ShadowDdev/OpenESC_20X20/hardware/BOM/export_project_20260803_234127.xls

4in1-mini.csv |  |  |  |  |  |  |  |  |  | LCSC BOM Quotation
 |  |  |  |  |  |  |  |  |  | BOM Date Created：03/08/26 23:38:18 |  |  |  | BOM Export Date: 03/08/26 23:41:27 |  |  |  | The matching result is a real-time query result, availability and prices may fluctuate. Backorder items are estimated prices for your reference, please submit "Create Quote" to get the real price. All information is provided "as is" and is subject to change without notice. Any use made of the information provided is without recourse to LCSC and at the user's risk.
 |  |  |  |  |  |  |  |  |  | EST TOTAL :$41.48 |  |  |  | Website：https://www.lcsc.com/bom | https://www.lcsc.com/bom | https://www.lcsc.com/bom | https://www.lcsc.com/bom
Uploaded data |  |  |  |  |  |  |  |  |  | LCSC Matching Results
LCSC# | Mfr. | Mrf# | Description | Package | Value | Customer Part Number | Quantity | Target Price(USD) | Target Lead Time(Business Days) | Mrf# | Mfr. | Order Qty. | Unit Price(USD) | Ext.Price(USD) | LCSC# | Package | Min | Mult | SPQ | Availability | Stock Status | Customer Notes | Description | Matched status | Product Link
C105226 |  |  | 22uF |  |  | - | 5 |  |  | CL05A226MQ5QUNC | Samsung Electro-Mechanics | 5 | 0.1031 | 0.52 | C105226 | - | 5 | 5 | 10000 | 0 | Backordered |  | 22uF ±20% 6.3V Ceramic Capacitor X5R 0402 | Exact Matches | https://uat.lcsc.com/product-detail/schottky-barrier-diodes-sbd_lge-10mq040n_C688893.html
C307331 |  |  | 100nF |  |  | - | 100 |  |  | CL05B104KB54PNC | Samsung Electro-Mechanics | 100 | 0.0053 | 0.53 | C307331 | - | 100 | 100 | 10000 | 8000 | In Stock |  | 100nF ±10% 50V Ceramic Capacitor X7R 0402 | Exact Matches
C2762594 |  |  | 22uF |  |  | - | 5 |  |  | CL10A226MO7JZNC | Samsung Electro-Mechanics | 5 | 0.1237 | 0.62 | C2762594 | - | 5 | 5 | 4000 | 219010 | In Stock |  | 22uF ±20% 16V Ceramic Capacitor X5R 0603 | Exact Matches
C181043 |  |  | 100nF |  |  | - | 100 |  |  | GRM033R6YA104KE14D | muRata | 100 | 0.0076 | 0.76 | C181043 | - | 100 | 100 | 15000 | 399200 | In Stock |  | 100nF ±10% 35V Ceramic Capacitor X5R 0201 | Exact Matches
C89632 |  |  | 10uF |  |  | - | 5 |  |  | CL31B106KBHNNNE | Samsung Electro-Mechanics | 5 | 0.2925 | 1.46 | C89632 | - | 5 | 5 | 2000 | 304110 | In Stock |  | 10uF ±10% 50V Ceramic Capacitor X7R 1206 | Exact Matches
C1977154 |  |  | SMF24A-T13 |  |  | - | 5 |  |  | SMF24A-T13 | Littelfuse | 5 | 0.1480 | 0.74 | C1977154 | - | 5 | 5 | 10000 | 8595 | In Stock |  | 38.9VC Clamp 5.1A Ipp TVS DIODE SOD-123FL | Exact Matches
C160407 |  |  | SM08B-SRSS-TB |  |  | - | 5 |  |  | SM08B-SRSS-TB(LF)(SN) | JST | 5 | 0.2524 | 1.26 | C160407 | - | 5 | 5 | 3000 | 322860 | In Stock |  | Connector Header 8 position 1mm Pitch 1A Surface Mount, Right Angle -25℃~+85℃ | Exact Matches
C49441966 |  |  | DOY180N03T |  |  | - | 100 |  |  | DOY180N03T | DOINGTER | 100 | 0.2715 | 27.15 | C49441966 | - | 1 | 1 | 5000 | 823 | In Stock |  | 30V 180A 1.3V 379W 1mΩ@10V 1 N-channel N-Channel TDFN3333-8PL Single FETs, MOSFETs RoHS | Exact Matches
C473542 |  |  | 15R |  |  | - | 100 |  |  | 0201WMF150JTEE | UNI-ROYAL | 100 | 0.0005 | 0.05 | C473542 | - | 100 | 100 | 15000 | 14700 | In Stock |  | 15Ω ±1% 50mW 0201 Thick Film Resistor | Exact Matches
C106225 |  |  | 10k |  |  | - | 100 |  |  | RC0201FR-0710KL | YAGEO | 100 | 0.0012 | 0.12 | C106225 | - | 100 | 100 | 10000 | 1659300 | In Stock |  | 50mW 10kΩ 25V Thick Film Resistor ±1% ±200ppm/℃ 0201 Chip Resistor - Surface Mount RoHS | Exact Matches
C226468 |  |  | 220R |  |  | - | 100 |  |  | AC0201FR-07220RL | YAGEO | 100 | 0.0010 | 0.10 | C226468 | - | 100 | 100 | 10000 | 44400 | In Stock |  | 220Ω ±1% 50mW 0201 Thick Film Resistor | Exact Matches
C270365 |  |  | 1k |  |  | - | 100 |  |  | 0201WMF1001TEE | UNI-ROYAL | 100 | 0.0004 | 0.04 | C270365 | - | 100 | 100 | 15000 | 1163200 | In Stock |  | 1kΩ ±1% 50mW 0201 Thick Film Resistor | Exact Matches
C270365 |  |  | 1k |  |  | - | 100 |  |  | 0201WMF1001TEE | UNI-ROYAL | 100 | 0.0004 | 0.04 | C270365 | - | 100 | 100 | 15000 | 1163200 | In Stock |  | 1kΩ ±1% 50mW 0201 Thick Film Resistor | Exact Matches
C106226 |  |  | 10R |  |  | - | 100 |  |  | RC0201FR-0710RL | YAGEO | 100 | 0.0019 | 0.19 | C106226 | - | 100 | 100 | 10000 | 174400 | In Stock |  | 50mW 10Ω 25V Thick Film Resistor ±1% -100ppm/℃~+350ppm/℃ 0201 Chip Resistor - Surface Mount RoHS | Exact Matches
C106225 |  |  | 10k |  |  | - | 100 |  |  | RC0201FR-0710KL | YAGEO | 100 | 0.0012 | 0.12 | C106225 | - | 100 | 100 | 10000 | 1659300 | In Stock |  | 50mW 10kΩ 25V Thick Film Resistor ±1% ±200ppm/℃ 0201 Chip Resistor - Surface Mount RoHS | Exact Matches
C166378 |  |  | 115k |  |  | - | 100 |  |  | RTT011153FTH | RALEC | 100 | 0.0007 | 0.07 | C166378 | - | 100 | 100 | 10000 | 16600 | In Stock |  | 115kΩ ±1% 50mW 0201 Thick Film Resistor | Exact Matches
C695806 |  |  | 0.2mR |  |  | - | 5 |  |  | ASR-S-3-0.2F | Yezhan | 5 | 0.2345 | 1.17 | C695806 | 2512 | 5 | 5 | 1000 | 2570 | In Stock |  | 6W 0.2mΩ Shunt ±175ppm/℃ ±1% 2512 Chip Resistor - Surface Mount RoHS | Exact Matches | https://www.lcsc.com/product-detail/C695806.html
C2848334 |  |  | TLV76733DRVR |  |  | - | 5 |  |  | TLV76733DRVR | TI | 5 | 0.1660 | 0.83 | C2848334 | - | 5 | 5 | 3000 | 12035 | In Stock |  | Linear Voltage Regulator IC Positive Fixed 1 Output 1A WSON-6(2x2) | Exact Matches
C2765098 |  |  | AT32F421G8U7 |  |  | - | 4 |  |  | AT32F421G8U7 | ARTERY | 4 | 0.6398 | 2.56 | C2765098 | - | 1 | 1 | 490 | 5496 | In Stock |  | ARM Cortex-M4 32 Bit 120MHz 23 QFN-28-EP(4x4) Microcontrollers RoHS | Exact Matches
C41414478 |  |  | NSG2065Q |  |  | - | 4 |  |  | NSG2065Q | WXNSIC | 4 | 0.3911 | 1.56 | C41414478 | - | 1 | 1 | 5000 | 3696 | In Stock |  | 5V~20V 1.5A 1.2A QFN-24-EP(4x4) Gate Drivers RoHS | Exact Matches
C46594347 |  |  | FTC160808S4R7MBCA |  |  | - | 5 |  |  | FTC160808S4R7MBCA | cjiang | 5 | 0.1217 | 0.61 | C46594347 | - | 5 | 5 | 3000 | 37850 | In Stock |  | 1A 4.7uH ±20% 585mΩ 1.2A Molded Inductor 0603 Fixed Inductors RoHS | Exact Matches
C2058245 |  |  | INA186A3IDCKR |  |  | - | 1 |  |  | INA186A3IDCKR | TI | 1 | 0.6721 | 0.67 | C2058245 | - | 1 | 1 | 3000 | 220 | In Stock |  | 1 3uV -200mV~40V 0.3V/us 150dB 500pA 48uA 100V/V SC-70-6 Instrumentation, Op Amps, Buffer Amps RoHS | Exact Matches
C5219316 |  |  | LMR54406DBVR |  |  | - | 1 |  |  | LMR54406DBVR | TI | 1 | 0.3087 | 0.31 | C5219316 | - | 1 | 1 | 3000 | 99933 | In Stock |  | Buck Switching Regulator IC Adjustable 1V~28V 1 Output 0.6A SOT-23-6 | Exact Matches
