ShadowDdev/OpenESC_20X20/hardware/4in1-mini.kicad_pcb

## KiCad design hardware/4in1-mini.kicad_pcb (2026-08-04)

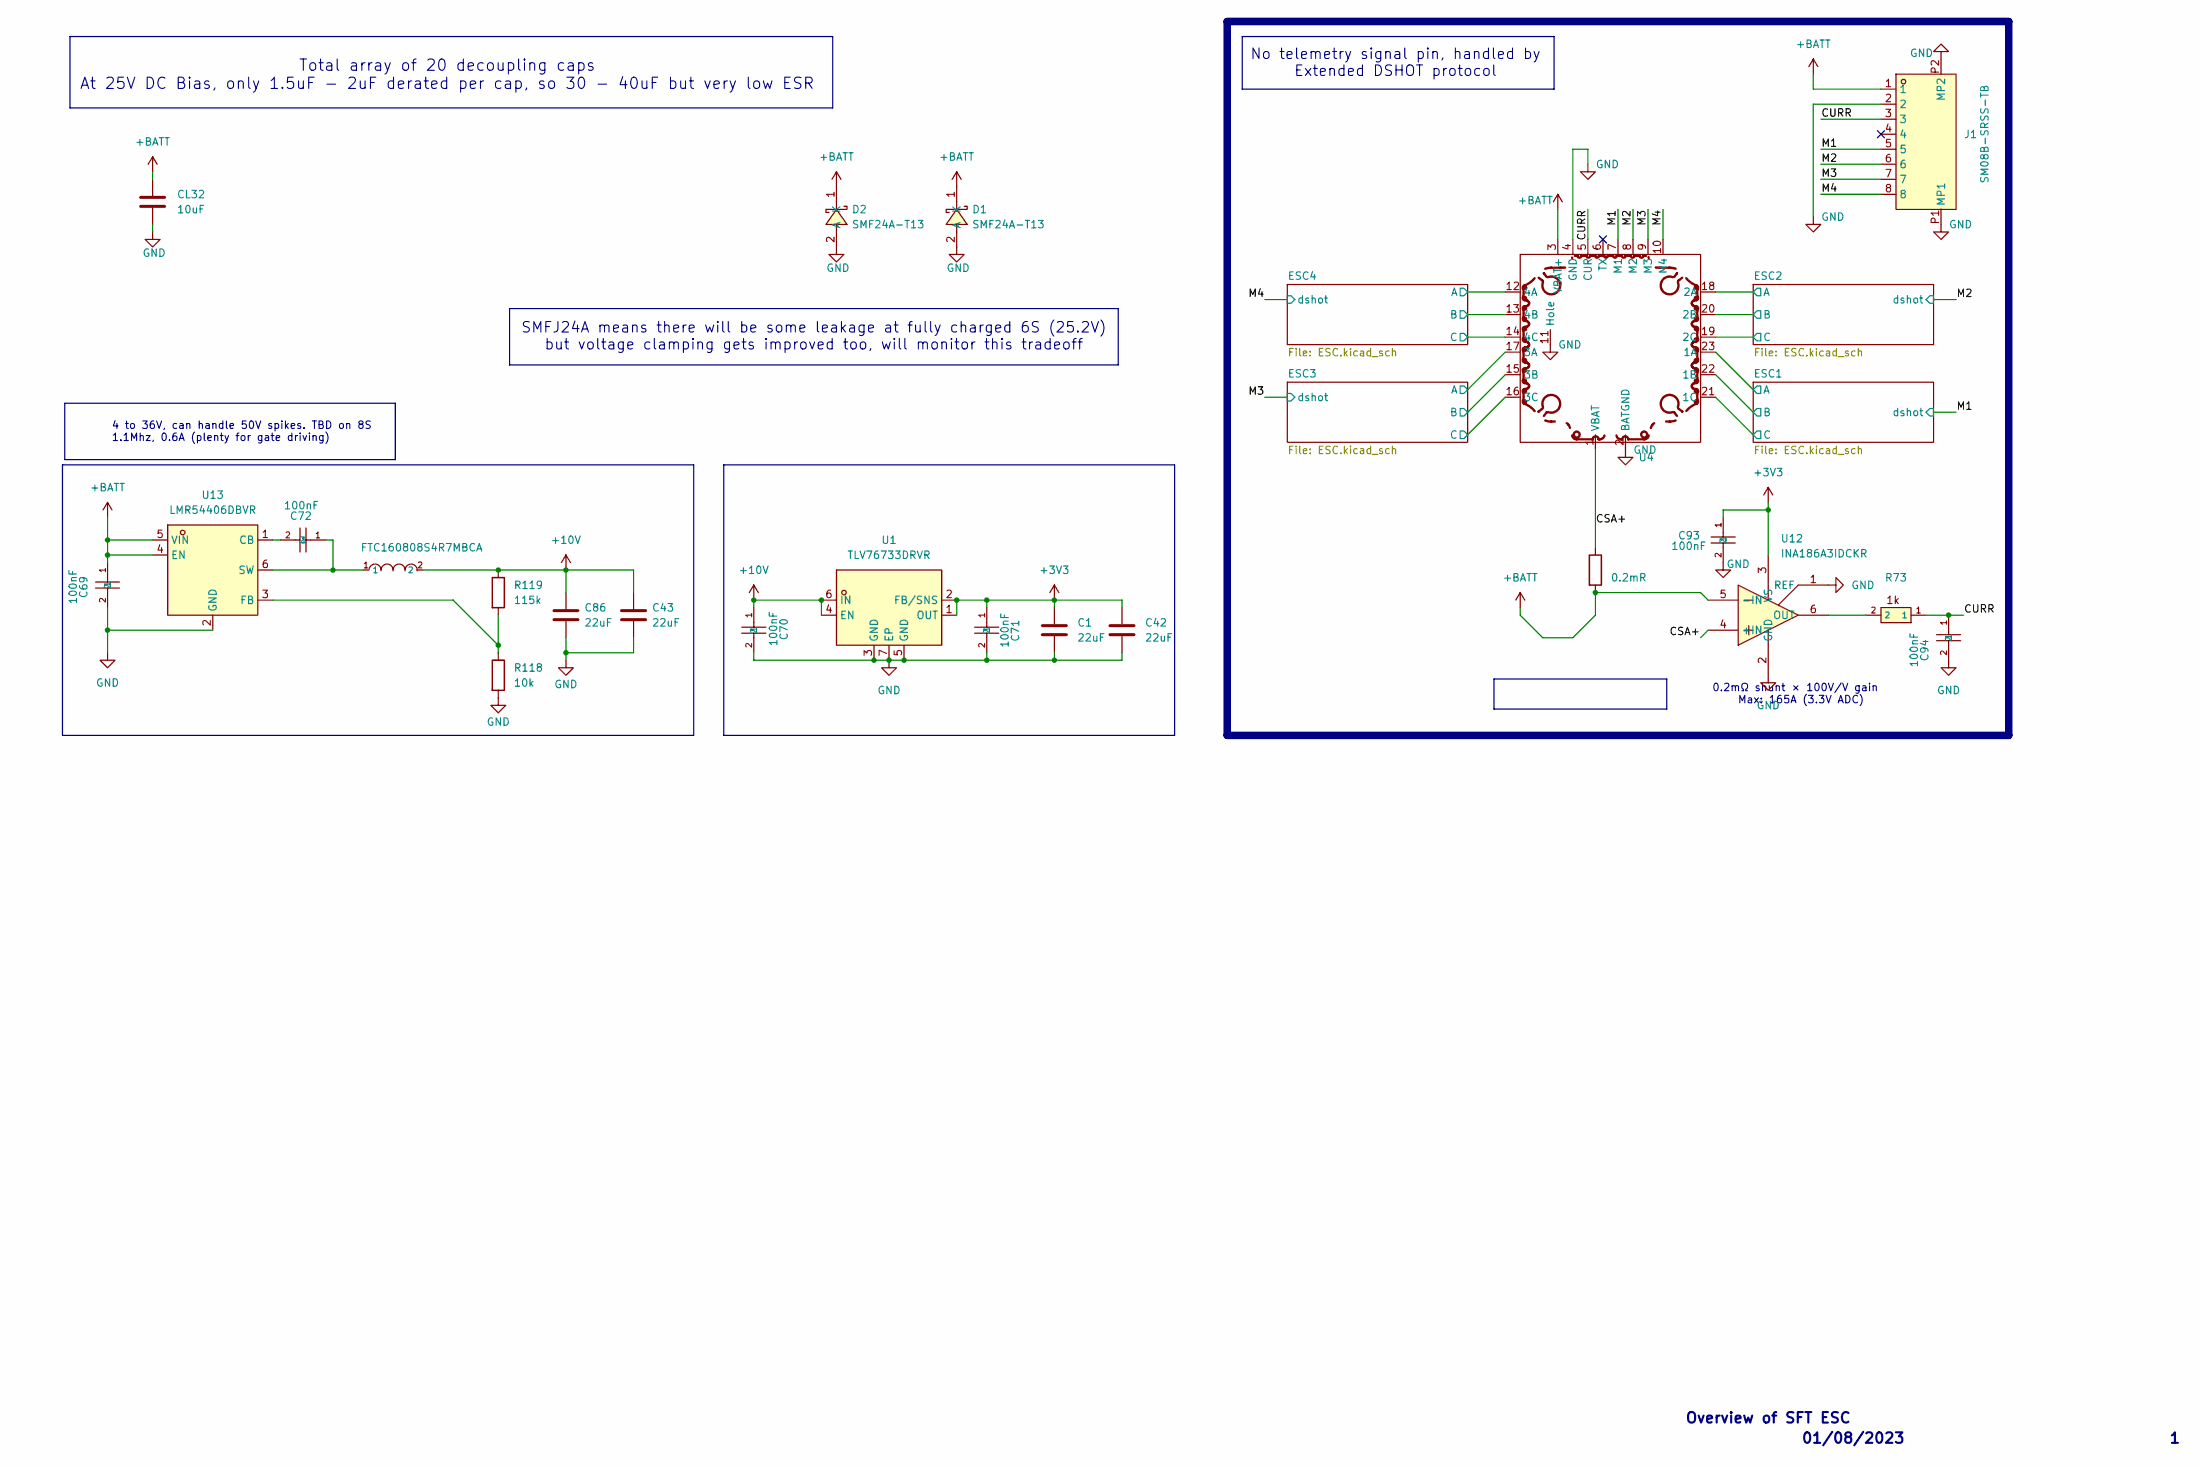
[picture p1: schematic 4in1-mini.kicad_sch]

Parts:
C1, C42: 22uF; C_0402_1005Metric; MPN CL05A226MQ5QUNC; LCSC C105226
C43, C86: 22uF; C_0603_1608Metric; MPN CL10A226MO7JZNC; LCSC C2762594
C69, C70, C71, C72, C93, C94: 100nF; C_0201_0603Metric; MPN GRM033R6YA104KE14D; LCSC C181043
CL32: 10uF; C_1206_3216Metric; MPN CL31B106KBHNNNE; LCSC C89632
D1, D2: SMF24A-T13; SOD-123FL_L2.7-W1.8-LS3.7-RD; MPN SMF24A-T13; LCSC Part C1977154
J1: SM08B-SRSS-TB; JST_SM08B-SRSS-TB; MPN SM08B-SRSS-TB(LF)(SN); LCSC C160407
R73: 1k; R_0201_0603Metric; MPN 0201WMF1001TEE; LCSC C270365
R118: 10k; R_0201_0603Metric; MPN RC0201FR-0710KL; LCSC C106225
R119: 115k; R_0201_0603Metric; MPN RTT011153FTH; LCSC C166378
Rsense1: 0.2mR; R_2512_6332Metric; MPN ASR-S-3-0.2F; LCSC C695806
U1: TLV76733DRVR; WSON-6_L2.0-W2.0-P0.65-TL-EP; MPN TLV76733DRVR; LCSC C2848334
U4: 4in1ESC
U5: FTC160808S4R7MBCA; IND-SMD_L1.6-W0.8_FTC160865SR47MBCA; MPN FTC160808S4R7MBCA; LCSC C46594347
U12: INA186A3IDCKR; SOT-363_SC-70-6; MPN INA186A3IDCKR; LCSC C2058245
U13: LMR54406DBVR; SOT-23-6_L2.9-W1.6-P0.95-LS2.8-BR; MPN LMR54406DBVR; LCSC Part C5219316

Connections:
+3V3: C1.2, C42.2, C71.1, C93.1, U1.1 (OUT), U1.2 (FB/SNS), U12.3 (VS); also elsewhere on the board
+10V: C43.1, C70.1, C86.1, R119.1, U1.4 (EN), U1.6 (IN), U5.2; also elsewhere on the board
+BATT: C69.1, CL32.1, D1.1 (K), D2.1 (K), J1.1, Rsense1.2, U4.3 (VBAT+), U12.5 (-IN), U13.4 (EN), U13.5 (VIN); also elsewhere on the board
/CSA+: Rsense1.1, U4.1 (VBAT), U12.4 (+IN)
/CURR: C94.1, J1.3, R73.1, U4.5 (CUR)
/ESC1/MotorA: U4.23 (1A); also elsewhere on the board
/ESC1/MotorB: U4.22 (1B); also elsewhere on the board
/ESC1/MotorC: U4.21 (1C); also elsewhere on the board
/ESC2/MotorA: U4.18 (2A); also elsewhere on the board
/ESC2/MotorB: U4.20 (2B); also elsewhere on the board
/ESC2/MotorC: U4.19 (2C); also elsewhere on the board
/ESC3/MotorA: U4.17 (3A); also elsewhere on the board
/ESC3/MotorB: U4.15 (3B); also elsewhere on the board
/ESC3/MotorC: U4.16 (3C); also elsewhere on the board
/ESC4/MotorA: U4.12 (4A); also elsewhere on the board
/ESC4/MotorB: U4.13 (4B); also elsewhere on the board
/ESC4/MotorC: U4.14 (4C); also elsewhere on the board
/M1: J1.5, U4.7 (M1); also elsewhere on the board
/M2: J1.6, U4.8 (M2); also elsewhere on the board
/M3: J1.7, U4.9 (M3); also elsewhere on the board
/M4: J1.8, U4.10 (M4); also elsewhere on the board
GND: C1.1, C42.1, C43.2, C69.2, C70.2, C71.2, C86.2, C93.2, C94.2, CL32.2, D1.2 (A), D2.2 (A), J1.2, J1.P1 (MP1), J1.P2 (MP2), R118.2, U1.3 (GND), U1.5 (GND), U1.7 (EP), U4.2 (BATGND), U4.4 (GND), U4.11 (Hole), U12.1 (REF), U12.2 (GND), U13.2 (GND); also elsewhere on the board
unnamed: R73.2, U12.6 (OUT)
unnamed: C72.2, U13.1 (CB)
unnamed: R118.1, R119.2, U13.3 (FB)
unnamed: C72.1, U5.1, U13.6 (SW)

Notes on the sheet:
01/08/2023
No telemetry signal pin, handled by Extended DSHOT protocol
4 to 36V, can handle 50V spikes. TBD on 8S 1.1Mhz, 0.6A (plenty for gate driving)
SMFJ24A means there will be some leakage at fully charged 6S (25.2V) but voltage clamping gets improved too, will monitor this tradeoff
Overview of SFT ESC
Total array of 20 decoupling caps At 25V DC Bias, only 1.5uF - 2uF derated per cap, so 30 - 40uF but very low ESR
0.2mΩ shunt × 100V/V gain Max: 165A (3.3V ADC)

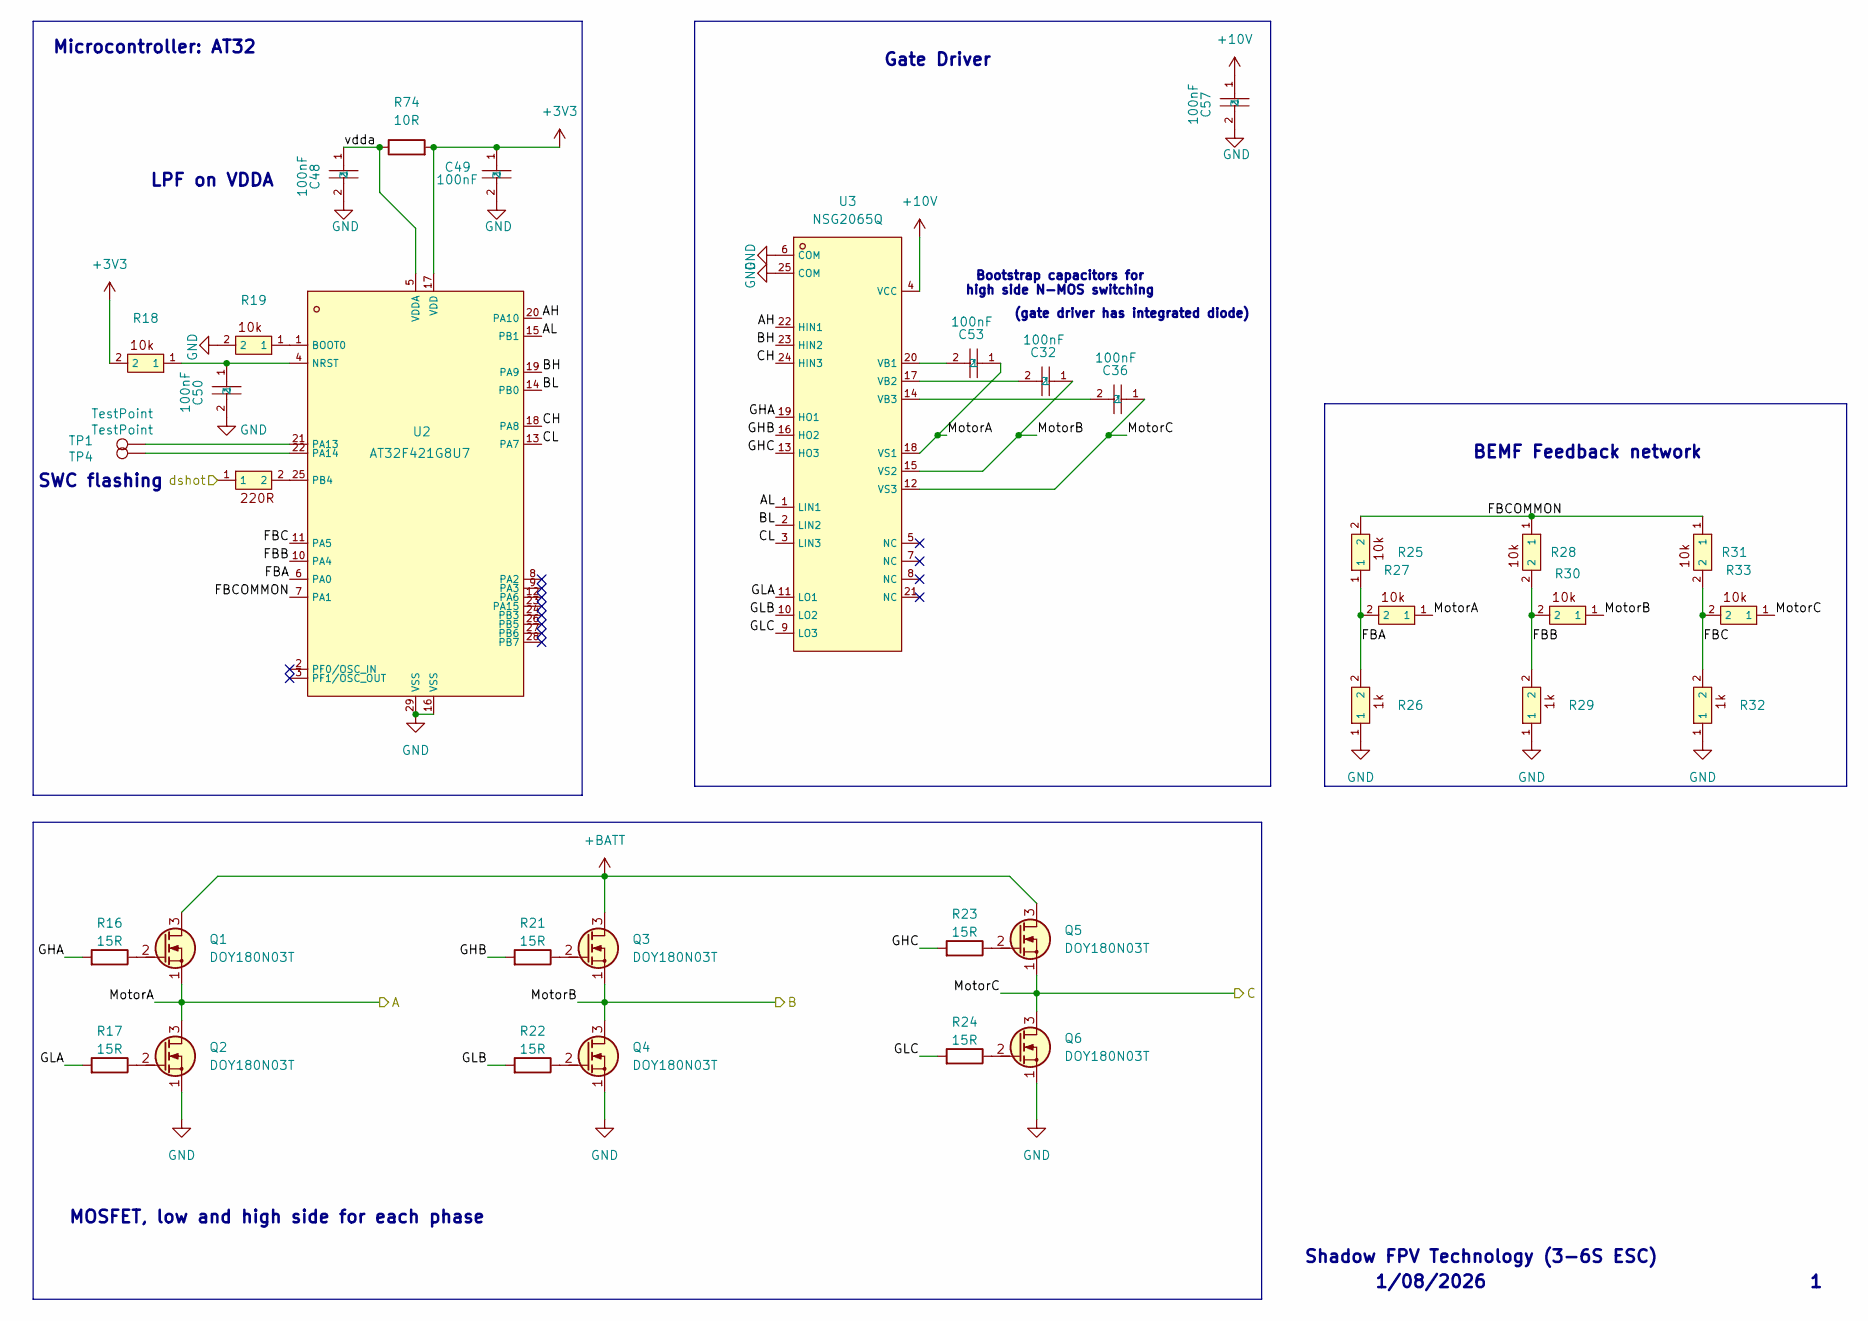
[picture p2: schematic ESC.kicad_sch]

Parts:
C32, C36, C53: 100nF; C_0402_WIDE; MPN CL05B104KB54PNC; LCSC C307331
C48, C49, C50, C57: 100nF; C_0201_0603Metric; MPN GRM033R6YA104KE14D; LCSC C181043
Q1, Q2, Q3, Q4, Q5, Q6: DOY180N03T; Diodes_PowerDI3333-8; MPN DOY180N03T; LCSC C49441966
R16, R17, R21, R22, R23, R24: 15R; R_0201_0603Metric; MPN 0201WMF150JTEE; LCSC C473542
R18, R19, R25, R27, R28, R30, R31, R33: 10k; R_0201_0603Metric; MPN RC0201FR-0710KL; LCSC C106225
R20: 220R; R_0201_0603Metric; MPN AC0201FR-07220RL; LCSC C226468
R26, R29, R32: 1k; R_0201_0603Metric; MPN 0201WMF1001TEE; LCSC C270365
R74: 10R; R_0201_0603Metric; MPN RC0201FR-0710RL; LCSC C106226
TP1, TP4: TestPoint; TestPoint_Pad_D1.0mm
U2: AT32F421G8U7; QFN-28_L4.0-W4.0-P0.40-TL-EP2.4; MPN AT32F421G8U7; LCSC C2765098
U3: NSG2065Q; QFN-24_L4.0-W4.0-P0.50-TL-EP2.8; MPN NSG2065Q; LCSC C41414478

Connections:
+3V3: C49.1, R18.2, R74.2, U2.17 (VDD); also elsewhere on the board
+10V: C57.1, U3.4 (VCC); also elsewhere on the board
+BATT: Q1.3 (D), Q3.3 (D), Q5.3 (D); also elsewhere on the board
/ESC1/AH: U2.20 (PA10), U3.22 (HIN1)
/ESC1/AL: U2.15 (PB1), U3.1 (LIN1)
/ESC1/BH: U2.19 (PA9), U3.23 (HIN2)
/ESC1/BL: U2.14 (PB0), U3.2 (LIN2)
/ESC1/CH: U2.18 (PA8), U3.24 (HIN3)
/ESC1/CL: U2.13 (PA7), U3.3 (LIN3)
/ESC1/FBA: R25.1, R26.2, R27.2, U2.6 (PA0)
/ESC1/FBB: R28.2, R29.2, R30.2, U2.10 (PA4)
/ESC1/FBC: R31.2, R32.2, R33.2, U2.11 (PA5)
/ESC1/FBCOMMON: R25.2, R28.1, R31.1, U2.7 (PA1)
/ESC1/GHA: R16.1, U3.19 (HO1)
/ESC1/GHB: R21.1, U3.16 (HO2)
/ESC1/GHC: R23.1, U3.13 (HO3)
/ESC1/GLA: R17.1, U3.11 (LO1)
/ESC1/GLB: R22.1, U3.10 (LO2)
/ESC1/GLC: R24.1, U3.9 (LO3)
/ESC1/MotorA: C53.1, Q1.1 (S), Q2.3 (D), R27.1, U3.18 (VS1); also elsewhere on the board
/ESC1/MotorB: C32.1, Q3.1 (S), Q4.3 (D), R30.1, U3.15 (VS2); also elsewhere on the board
/ESC1/MotorC: C36.1, Q5.1 (S), Q6.3 (D), R33.1, U3.12 (VS3); also elsewhere on the board
/ESC1/vdda: C48.1, R74.1, U2.5 (VDDA)
/M1: R20.1; also elsewhere on the board
GND: C48.2, C49.2, C50.2, C57.2, Q2.1 (S), Q4.1 (S), Q6.1 (S), R19.2, R26.1, R29.1, R32.1, U2.16 (VSS), U2.29 (VSS), U3.6 (COM), U3.25 (COM); also elsewhere on the board
unnamed: Q1.2 (G), R16.2
unnamed: Q2.2 (G), R17.2
unnamed: Q3.2 (G), R21.2
unnamed: Q4.2 (G), R22.2
unnamed: Q5.2 (G), R23.2
unnamed: Q6.2 (G), R24.2
unnamed: R19.1, U2.1 (BOOT0)
unnamed: C50.1, R18.1, U2.4 (NRST)
unnamed: TP1.1 (1_1), U2.21 (PA13)
unnamed: TP4.1 (1_1), U2.22 (PA14)
unnamed: R20.2, U2.25 (PB4)
unnamed: C53.2, U3.20 (VB1)
unnamed: C32.2, U3.17 (VB2)
unnamed: C36.2, U3.14 (VB3)

Parts of its further copies:
C33, C34, C35, C37, C38, C39, C59, C73, C83: 100nF; C_0402_WIDE; MPN CL05B104KB54PNC; LCSC C307331
C44, C45, C46, C63, C64, C65, C66, C77, C78, C79, C80, C88: 100nF; C_0201_0603Metric; MPN GRM033R6YA104KE14D; LCSC C181043
Q7, Q8, Q9, Q10, Q11, Q12, Q13, Q14, Q15, Q16, Q17, Q18, Q19, Q20, Q21, Q22, Q23, Q24: DOY180N03T; Diodes_PowerDI3333-8; MPN DOY180N03T; LCSC C49441966
R1, R2, R6, R7, R8, R9, R37, R38, R42, R43, R44, R45, R55, R56, R60, R61, R62, R63: 15R; R_0201_0603Metric; MPN 0201WMF150JTEE; LCSC C473542
R3, R4, R10, R12, R13, R15, R34, R36, R39, R40, R46, R48, R49, R51, R52, R54, R57, R58, R64, R66, R67, R69, R70, R72: 10k; R_0201_0603Metric; MPN RC0201FR-0710KL; LCSC C106225
R5, R41, R59: 220R; R_0201_0603Metric; MPN AC0201FR-07220RL; LCSC C226468
R11, R14, R35, R47, R50, R53, R65, R68, R71: 1k; R_0201_0603Metric; MPN 0201WMF1001TEE; LCSC C270365
R75, R76, R77: 10R; R_0201_0603Metric; MPN RC0201FR-0710RL; LCSC C106226
TP2, TP3, TP5, TP6, TP7, TP8: TestPoint; TestPoint_Pad_D1.0mm
U6, U8, U10: AT32F421G8U7; QFN-28_L4.0-W4.0-P0.40-TL-EP2.4; MPN AT32F421G8U7; LCSC C2765098
U7, U9, U11: NSG2065Q; QFN-24_L4.0-W4.0-P0.50-TL-EP2.8; MPN NSG2065Q; LCSC C41414478

Connections of its further copies:
+3V3: C45.1, C65.1, C79.1, R3.2, R39.2, R57.2, R75.2, R76.2, R77.2, U6.17 (VDD), U8.17 (VDD), U10.17 (VDD); also elsewhere on the board
+10V: C63.1, C77.1, C88.1, U7.4 (VCC), U9.4 (VCC), U11.4 (VCC); also elsewhere on the board
+BATT: Q7.3 (D), Q9.3 (D), Q11.3 (D), Q13.3 (D), Q15.3 (D), Q17.3 (D), Q19.3 (D), Q21.3 (D), Q23.3 (D); also elsewhere on the board
/ESC2/AH: U6.20 (PA10), U7.22 (HIN1)
/ESC2/AL: U6.15 (PB1), U7.1 (LIN1)
/ESC2/BH: U6.19 (PA9), U7.23 (HIN2)
/ESC2/BL: U6.14 (PB0), U7.2 (LIN2)
/ESC2/CH: U6.18 (PA8), U7.24 (HIN3)
/ESC2/CL: U6.13 (PA7), U7.3 (LIN3)
/ESC2/FBA: R10.1, R11.2, R12.2, U6.6 (PA0)
/ESC2/FBB: R13.2, R14.2, R15.2, U6.10 (PA4)
/ESC2/FBC: R34.2, R35.2, R36.2, U6.11 (PA5)
/ESC2/FBCOMMON: R10.2, R13.1, R34.1, U6.7 (PA1)
/ESC2/GHA: R1.1, U7.19 (HO1)
/ESC2/GHB: R6.1, U7.16 (HO2)
/ESC2/GHC: R8.1, U7.13 (HO3)
/ESC2/GLA: R2.1, U7.11 (LO1)
/ESC2/GLB: R7.1, U7.10 (LO2)
/ESC2/GLC: R9.1, U7.9 (LO3)
/ESC2/MotorA: C59.1, Q7.1 (S), Q8.3 (D), R12.1, U7.18 (VS1); also elsewhere on the board
/ESC2/MotorB: C33.1, Q9.1 (S), Q10.3 (D), R15.1, U7.15 (VS2); also elsewhere on the board
/ESC2/MotorC: C37.1, Q11.1 (S), Q12.3 (D), R36.1, U7.12 (VS3); also elsewhere on the board
/ESC2/vdda: C44.1, R75.1, U6.5 (VDDA)
/ESC3/AH: U8.20 (PA10), U9.22 (HIN1)
/ESC3/AL: U8.15 (PB1), U9.1 (LIN1)
/ESC3/BH: U8.19 (PA9), U9.23 (HIN2)
/ESC3/BL: U8.14 (PB0), U9.2 (LIN2)
/ESC3/CH: U8.18 (PA8), U9.24 (HIN3)
/ESC3/CL: U8.13 (PA7), U9.3 (LIN3)
/ESC3/FBA: R46.1, R47.2, R48.2, U8.6 (PA0)
/ESC3/FBB: R49.2, R50.2, R51.2, U8.10 (PA4)
/ESC3/FBC: R52.2, R53.2, R54.2, U8.11 (PA5)
/ESC3/FBCOMMON: R46.2, R49.1, R52.1, U8.7 (PA1)
/ESC3/GHA: R37.1, U9.19 (HO1)
/ESC3/GHB: R42.1, U9.16 (HO2)
/ESC3/GHC: R44.1, U9.13 (HO3)
/ESC3/GLA: R38.1, U9.11 (LO1)
/ESC3/GLB: R43.1, U9.10 (LO2)
/ESC3/GLC: R45.1, U9.9 (LO3)
/ESC3/MotorA: C73.1, Q13.1 (S), Q14.3 (D), R48.1, U9.18 (VS1); also elsewhere on the board
/ESC3/MotorB: C34.1, Q15.1 (S), Q16.3 (D), R51.1, U9.15 (VS2); also elsewhere on the board
/ESC3/MotorC: C38.1, Q17.1 (S), Q18.3 (D), R54.1, U9.12 (VS3); also elsewhere on the board
/ESC3/vdda: C64.1, R76.1, U8.5 (VDDA)
/ESC4/AH: U10.20 (PA10), U11.22 (HIN1)
/ESC4/AL: U10.15 (PB1), U11.1 (LIN1)
/ESC4/BH: U10.19 (PA9), U11.23 (HIN2)
/ESC4/BL: U10.14 (PB0), U11.2 (LIN2)
/ESC4/CH: U10.18 (PA8), U11.24 (HIN3)
/ESC4/CL: U10.13 (PA7), U11.3 (LIN3)
/ESC4/FBA: R64.1, R65.2, R66.2, U10.6 (PA0)
/ESC4/FBB: R67.2, R68.2, R69.2, U10.10 (PA4)
/ESC4/FBC: R70.2, R71.2, R72.2, U10.11 (PA5)
/ESC4/FBCOMMON: R64.2, R67.1, R70.1, U10.7 (PA1)
/ESC4/GHA: R55.1, U11.19 (HO1)
/ESC4/GHB: R60.1, U11.16 (HO2)
/ESC4/GHC: R62.1, U11.13 (HO3)
/ESC4/GLA: R56.1, U11.11 (LO1)
/ESC4/GLB: R61.1, U11.10 (LO2)
/ESC4/GLC: R63.1, U11.9 (LO3)
/ESC4/MotorA: C83.1, Q19.1 (S), Q20.3 (D), R66.1, U11.18 (VS1); also elsewhere on the board
/ESC4/MotorB: C35.1, Q21.1 (S), Q22.3 (D), R69.1, U11.15 (VS2); also elsewhere on the board
/ESC4/MotorC: C39.1, Q23.1 (S), Q24.3 (D), R72.1, U11.12 (VS3); also elsewhere on the board
/ESC4/vdda: C78.1, R77.1, U10.5 (VDDA)
/M2: R5.1; also elsewhere on the board
/M3: R41.1; also elsewhere on the board
/M4: R59.1; also elsewhere on the board
GND: C44.2, C45.2, C46.2, C63.2, C64.2, C65.2, C66.2, C77.2, C78.2, C79.2, C80.2, C88.2, Q8.1 (S), Q10.1 (S), Q12.1 (S), Q14.1 (S), Q16.1 (S), Q18.1 (S), Q20.1 (S), Q22.1 (S), Q24.1 (S), R4.2, R11.1, R14.1, R35.1, R40.2, R47.1, R50.1, R53.1, R58.2, R65.1, R68.1, R71.1, U6.16 (VSS), U6.29 (VSS), U7.6 (COM), U7.25 (COM), U8.16 (VSS), U8.29 (VSS), U9.6 (COM), U9.25 (COM), U10.16 (VSS), U10.29 (VSS), U11.6 (COM), U11.25 (COM); also elsewhere on the board
unnamed: Q7.2 (G), R1.2
unnamed: Q8.2 (G), R2.2
unnamed: Q9.2 (G), R6.2
unnamed: Q10.2 (G), R7.2
unnamed: Q11.2 (G), R8.2
unnamed: Q12.2 (G), R9.2
unnamed: Q13.2 (G), R37.2
unnamed: Q14.2 (G), R38.2
unnamed: Q15.2 (G), R42.2
unnamed: Q16.2 (G), R43.2
unnamed: Q17.2 (G), R44.2
unnamed: Q18.2 (G), R45.2
unnamed: Q19.2 (G), R55.2
unnamed: Q20.2 (G), R56.2
unnamed: Q21.2 (G), R60.2
unnamed: Q22.2 (G), R61.2
unnamed: Q23.2 (G), R62.2
unnamed: Q24.2 (G), R63.2
unnamed: R4.1, U6.1 (BOOT0)
unnamed: C46.1, R3.1, U6.4 (NRST)
unnamed: TP2.1 (1_1), U6.21 (PA13)
unnamed: TP3.1 (1_1), U6.22 (PA14)
unnamed: R5.2, U6.25 (PB4)
unnamed: C59.2, U7.20 (VB1)
unnamed: C33.2, U7.17 (VB2)
unnamed: C37.2, U7.14 (VB3)
unnamed: R40.1, U8.1 (BOOT0)
unnamed: C66.1, R39.1, U8.4 (NRST)
unnamed: TP5.1 (1_1), U8.21 (PA13)
unnamed: TP6.1 (1_1), U8.22 (PA14)
unnamed: R41.2, U8.25 (PB4)
unnamed: C73.2, U9.20 (VB1)
unnamed: C34.2, U9.17 (VB2)
unnamed: C38.2, U9.14 (VB3)
unnamed: R58.1, U10.1 (BOOT0)
unnamed: C80.1, R57.1, U10.4 (NRST)
unnamed: TP7.1 (1_1), U10.21 (PA13)
unnamed: TP8.1 (1_1), U10.22 (PA14)
unnamed: R59.2, U10.25 (PB4)
unnamed: C83.2, U11.20 (VB1)
unnamed: C35.2, U11.17 (VB2)
unnamed: C39.2, U11.14 (VB3)

Notes on the sheet:
Bootstrap capacitors for high side N-MOS switching
Gate Driver
MOSFET, low and high side for each phase
Shadow FPV Technology (3-6S ESC)
Microcontroller: AT32
SWC flashing
(gate driver has integrated diode)
1/08/2026
BEMF Feedback network
LPF on VDDA

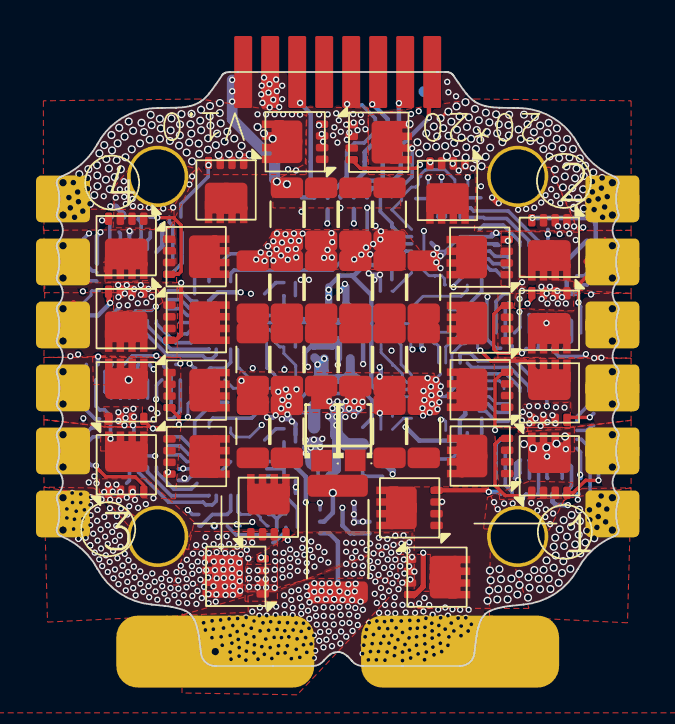
[picture p3: board 4in1-mini.kicad_pcb from above]

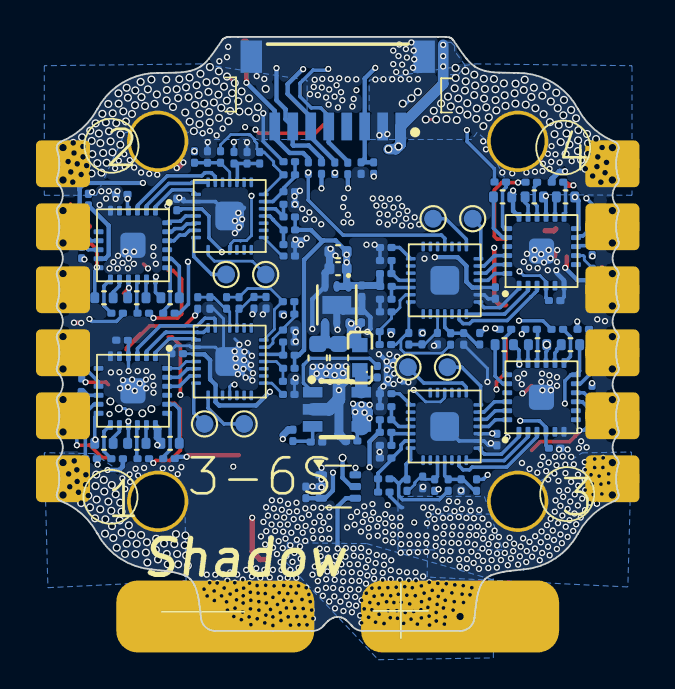
[picture p4: board 4in1-mini.kicad_pcb from below]

Board: 6 copper layers, 31.2 x 33.0 mm, 186 parts (138 on the bottom side), 150 nets.

Other parts of the board:
CL33, CL34, CL35, CL36, CL38, CL39, CL40, CL42, CL43, CL44, CL45, CL46, CL47, CL48, CL49, CL50, CL51, CL54, CL55: 10uF; C_1206_3216Metric

Their connections:
+BATT: CL33.1, CL34.1, CL35.1, CL36.1, CL38.1, CL39.1, CL40.1, CL42.1, CL43.1, CL44.1, CL45.1, CL46.1, CL47.1, CL48.1, CL49.1, CL50.1, CL51.1, CL54.1, CL55.1; also elsewhere on the board
GND: CL33.2, CL34.2, CL35.2, CL36.2, CL38.2, CL39.2, CL40.2, CL42.2, CL43.2, CL44.2, CL45.2, CL46.2, CL47.2, CL48.2, CL49.2, CL50.2, CL51.2, CL54.2, CL55.2; also elsewhere on the board
